hongchen1092/2-WayFSOCommunication/README.md

# 2-WayFSOCommunication
Design project with regards to a 2-way free space optical communications system, using optical laser transmitter &amp; photodiode sensor receiver
