hongchen1092/2-WayFSOCommunication/Code/Combined_Final/Rx_Device/readme.md

code for rx (device side) of the setup
no any managed components or build files
do a fresh clean build - .yml handles all required components
