hongchen1092/2-WayFSOCommunication/Simulations/Final Receiver.jpg

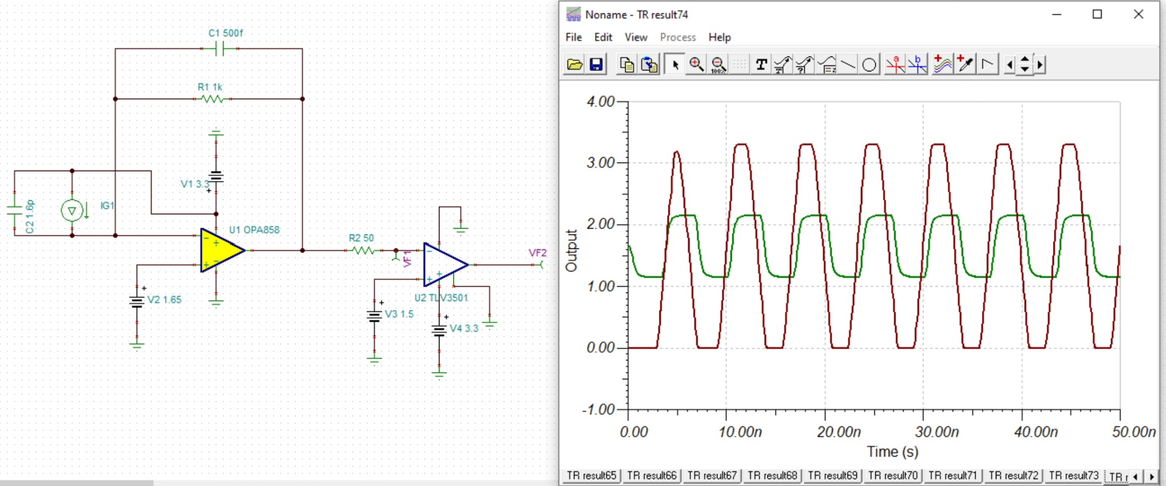
Simulations/Final Receiver.jpg
