hongchen1092/2-WayFSOCommunication/PCB Files/Test PCB version 3.0/BOM_END-PCB-Design-Project-2025_2025-10-28.csv

ID | Name | Designator | Footprint | Quantity | Manufacturer Part | Manufacturer | Supplier | Supplier Part | Price
1 | 1kΩ | R3 | R0402 | 1 | ERA2AEB102X | PANASONIC(松下) | LCSC | C445596
2 | 100nF | C10,C18,C4,C6,C8 | C0402 | 5 | CL05B104KO5NNNC | SAMSUNG(三星) | LCSC | C1525
3 | 4.7uF | C19,C20,C7,C9 | C0402 | 4 | CL05A475MP5NRNC | SAMSUNG(三星) | LCSC | C23733
4 | S8050T_C22435136 | Q2,Q3 | SOT-523-3_L1.6-W0.8-P1.00-LS1.6-BR | 2 | S8050T | TECH PUBLIC(台舟) | LCSC | C22435136
5 | 10kΩ | R2,R9 | R0402 | 2 | 0402WGF1002TCE | UNI-ROYAL(厚声) | LCSC | C25744
6 | CH343P | U8 | TQFN-16_L3.0-W3.0-P0.50-BL-EP1.7 | 1 | CH343P | WCH(南京沁恒) | LCSC | C2846043
7 | USB90-01-T1-W | USB,SERIAL | USB-A-TH_USB90-02-T1-3A-B1 | 2 | USB90-01-T1-W | Yuandi(元迪) | LCSC | C7419758
8 | 10uF | C1,C3 | C0603 | 2 | CL10A106MA8NRNC | SAMSUNG(三星) | LCSC | C96446
9 | 22uF | C2,C5 | C0805 | 2 | CL21A226MAQNNNE | SAMSUNG(三星) | LCSC | C45783
10 | 10nF | C11,C12,C13,C15,C16,C17 | C0402 | 6 | CL05B103KB5NNNC | SAMSUNG(三星) | LCSC | C15195
11 | 0.5pF | C14 | C0402 | 1 | GJM1555C1HR50WB01D | muRata(村田) | LCSC | C76912
12 | 100uF | C22 | C1210 | 1 | EMK325ABJ107MM-P | TAIYO YUDEN(太诱) | LCSC | C90143
13 | 0603White light_C2290 | LED2 | LED0603-R-RD_WHITE | 1 | KT-0603W | KENTO | LCSC | C2290
14 | S5973 | PD1 | TO-18-3 | 1
15 | 2N7002,215 | Q1 | SOT-23_L2.9-W1.3-P1.90-LS2.4-BR | 1 | 2N7002,215 | Nexperia(安世) | LCSC | C65189
16 | 200Ω | R1 | RES-ADJ-TH_3296X-8MM | 1 | 3296X-1-201-8mm | BOCHEN(博晨) | LCSC | C330440
17 | 1kΩ | R4,R5,R13 | R0402 | 3 | 0402WGF1001TCE | UNI-ROYAL(厚声) | LCSC | C11702
18 | 10Ω | R6 | R0402 | 1 | AR02BTC0100 | Viking(光颉) | LCSC | C319919
19 | 10kΩ | R11,R22 | R0402 | 2 | RT0402FRE0710KL | YAGEO(国巨) | LCSC | C723366
20 | 50Ω | U3 | R0402 | 1 | RT0402BRE0750RL | YAGEO(国巨) | LCSC | C853312
21 | 4.7Ω | R7 | R0805 | 1 | AS05W2J047JT5E | UNI-ROYAL(厚声) | LCSC | C2770032
22 | 75Ω | R8 | R0603 | 1 | ERJPA3F75R0V | PANASONIC(松下) | LCSC | C441915
23 | B3U-1000P | SW1,SW2 | KEY-SMD_B3U-1000PM | 2 | B3U-1000P | OMRON(欧姆龙) | LCSC | C231329
24 | TLV3501AIDBVRG4 | U1 | SOT-23-6_L2.9-W1.6-P0.95-LS2.8-BR | 1 | TLV3501AIDBVRG4 | TI(德州仪器) | LCSC | C3658928
25 | AMS1117-3.3 | U2 | SOT-223-3_L6.5-W3.4-P2.30-LS7.0-BR | 1 | AMS1117-3.3 | AMS | LCSC | C6186
26 | ESP32-S3-WROOM-1(N16) | U4 | WIRELM-SMD_ESP32-S3-WROOM-1 | 1 | ESP32-S3-WROOM-1-N16 | ESPRESSIF(乐鑫) | LCSC | C2913199
27 | RBS1MM40ATR | U5 | SOD-123FL_L2.6-W1.6-LS3.5-RD | 1 | RBS1MM40ATR | ROHM(罗姆) | LCSC | C5336770
28 | OPA858IDSGR | U6 | WSON-8_L2.0-W2.0-P0.50-TL-EP | 1 | OPA858IDSGR | TI(德州仪器) | LCSC | C970232
29 | UCC27512MDRSTEP | U7 | SON-6_L3.0-W3.0-P0.95-TL-EP | 1 | UCC27512MDRSTEP | TI(德州仪器) | LCSC | C2677110
30 | 5kΩ | VR1 | RES-ADJ-SMD_3224W | 1 | 3224W-1-502E | BOURNS | LCSC | C81349
31 | Laserdiode_TO18(5_6) | LD1 | LASER DIODE 5.6MM PCB | 1 |  |  |  | HLD980050N4T
32 | KT-0603R | LED1 | LED0603-RD | 1 | KT-0603R | KENTO | LCSC | C2286
