hongchen1092/2-WayFSOCommunication/Budget Summary/Project Budget.xlsx

Column5 | Column1 | Column2 | Column3 | Column32 | Column4
# | Item | Supplier | Invoice # | Avilability | Amount (AUD)
1 | ESP32 MCU + USB A Port | Altronics | 1 | yes | 46.7
2 | Laser, LDR, Sliding Pot and Mosfet | Jaycar | 2 | yes | 23.25
3 | Photodiodes SHP203 P | RS Components | 3 | yes | 10.1
4 | Test PCB (5 pack) | JLC PCB | 4 | yes | 29.55
5 | Components for PCB Assembly (in USD) | LCSC Parts | 5 | yes | 140.27
6 | Laser Lenses | AliExpress | 6 | yes | 16.71
7 | Final PCB with half SMT Assembly | JLC PCB | 7 | yes | 163.74
8 | Enclosure + Shipping | JLC3D | 8 | yes | 31.2
9 | Resistors (10K, 220ohm,1k) | Altronics | 9 | yes | 3.9
10 | Nut and bolts for enclouser (M3 25mm) | Bunnings | 10 | yes | 2.8
11 | Heat srink, Wires | Altronics | 11 | yes | 3.4
12 | Miscellaneous (Cleanig agent, solder and wires) |  | None | Wear items | 9.5
13 | Alignment Tripods | Kmart | 12 | yes | 13
 |  | Total |  |  | 494.12
