hongchen1092/2-WayFSOCommunication/Enclosure/TOP.stl

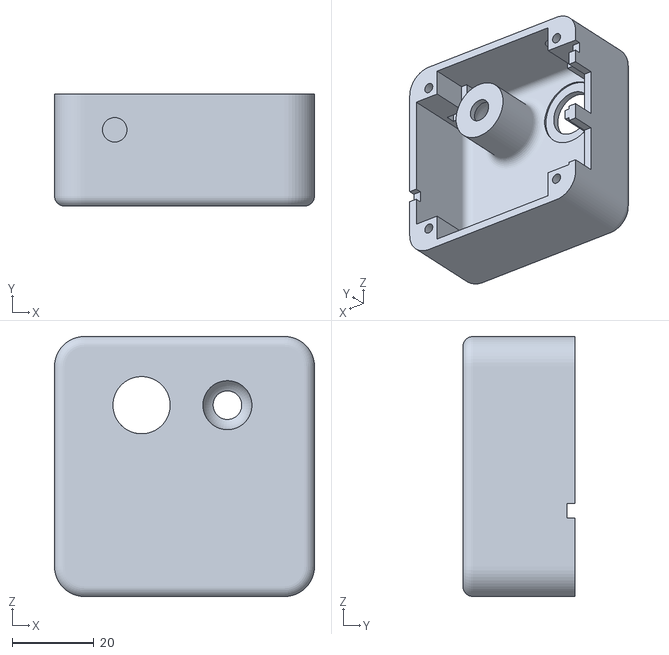
[picture p2: CAD file, 2025-10-28]
Enclosure/TOP.stl
63.6 x 27.5 x 63.6
