hongchen1092/2-WayFSOCommunication/Enclosure/Bottom.stl

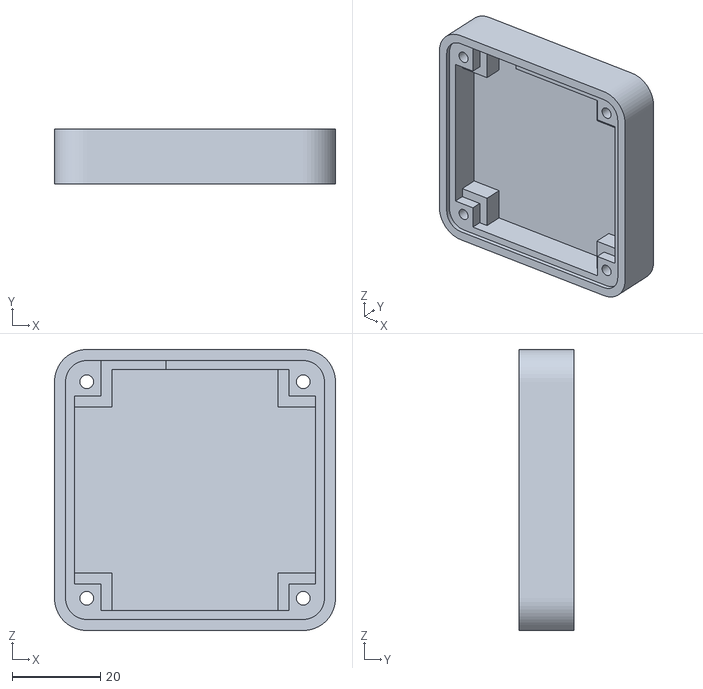
[picture p3: CAD file, 2025-10-28]
Enclosure/Bottom.stl
63.6 x 12.5 x 63.6
