hongchen1092/2-WayFSOCommunication/Lab-Test oscilloscope results/IN vs Comparator OUT.png

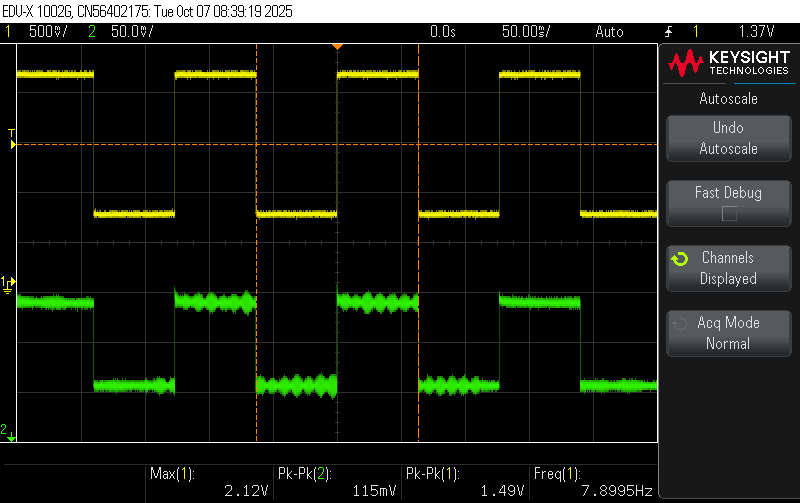
Lab-Test oscilloscope results/IN vs Comparator OUT.png
