hongchen1092/2-WayFSOCommunication/Lab-Test oscilloscope results/IN vs OPamp OUT.png

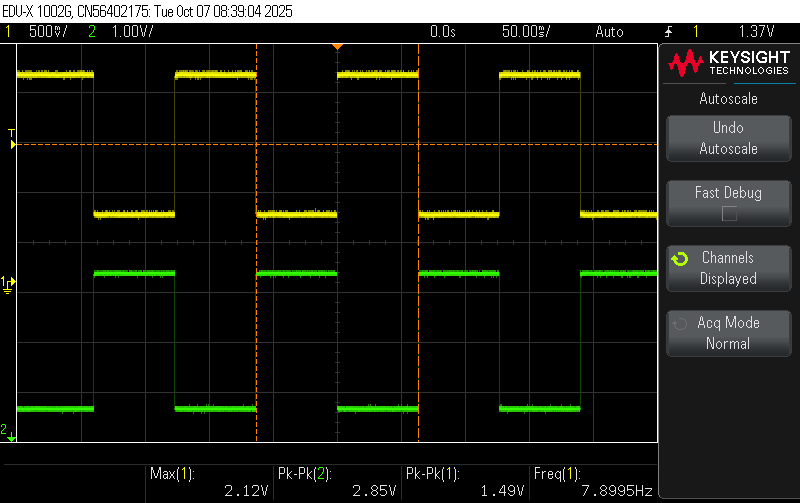
Lab-Test oscilloscope results/IN vs OPamp OUT.png
