hongchen1092/2-WayFSOCommunication/Lab-Test oscilloscope results/Link Propagation Delay.png

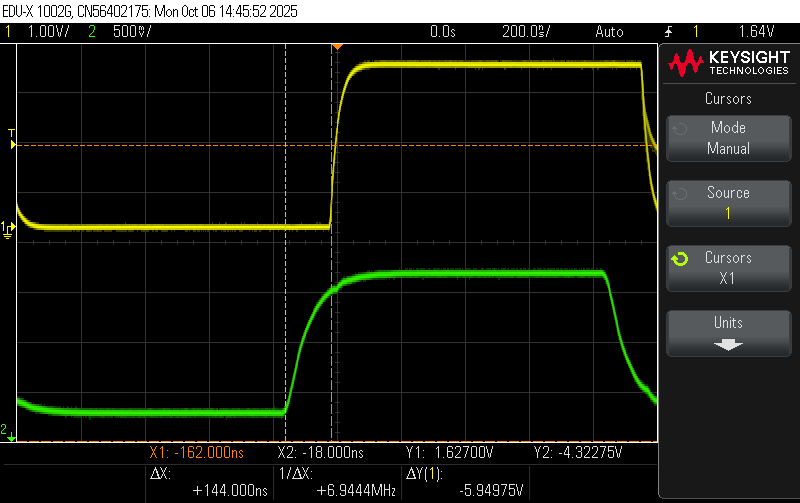
Lab-Test oscilloscope results/Link Propagation Delay.png
