hongchen1092/2-WayFSOCommunication/Lab-Test oscilloscope results/Receiver/Vout vs Rx Out.png

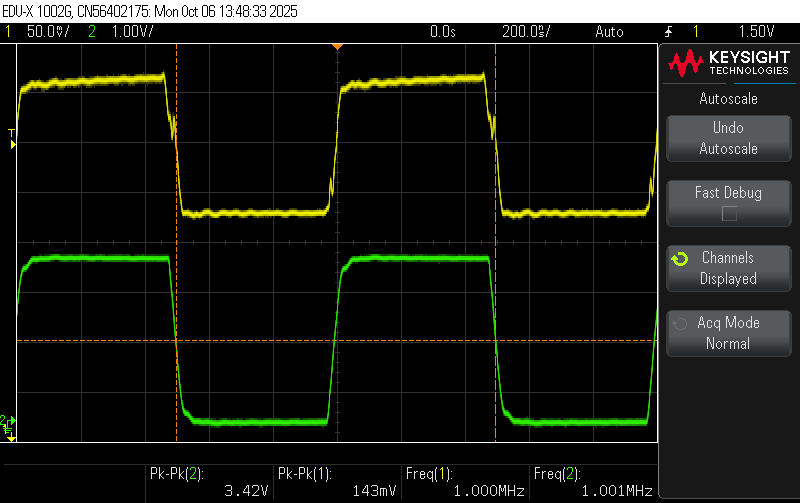
Lab-Test oscilloscope results/Receiver/Vout vs Rx Out.png
