hongchen1092/2-WayFSOCommunication/Lab-Test oscilloscope results/Receiver/Vref Tune.png

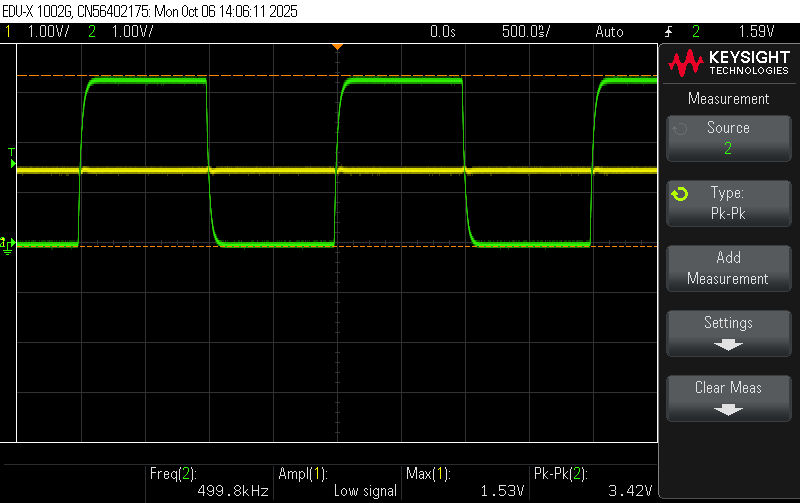
Lab-Test oscilloscope results/Receiver/Vref Tune.png
