hongchen1092/2-WayFSOCommunication/Lab-Test oscilloscope results/Transmitter/Tx In.png

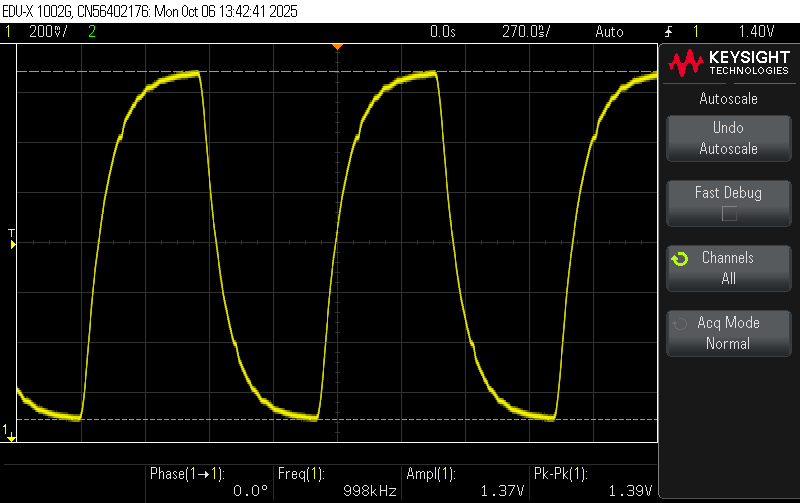
Lab-Test oscilloscope results/Transmitter/Tx In.png
