hongchen1092/2-WayFSOCommunication/Lab-Test oscilloscope results/Transmitter/Tx Out.png

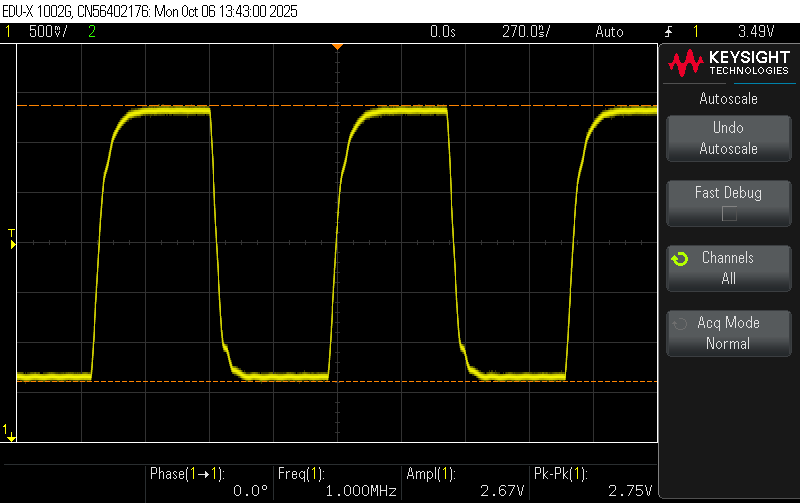
Lab-Test oscilloscope results/Transmitter/Tx Out.png
