hongchen1092/2-WayFSOCommunication/Schematics/Final Schematic_Design-Project-v3.0.pdf

## TX1VCC

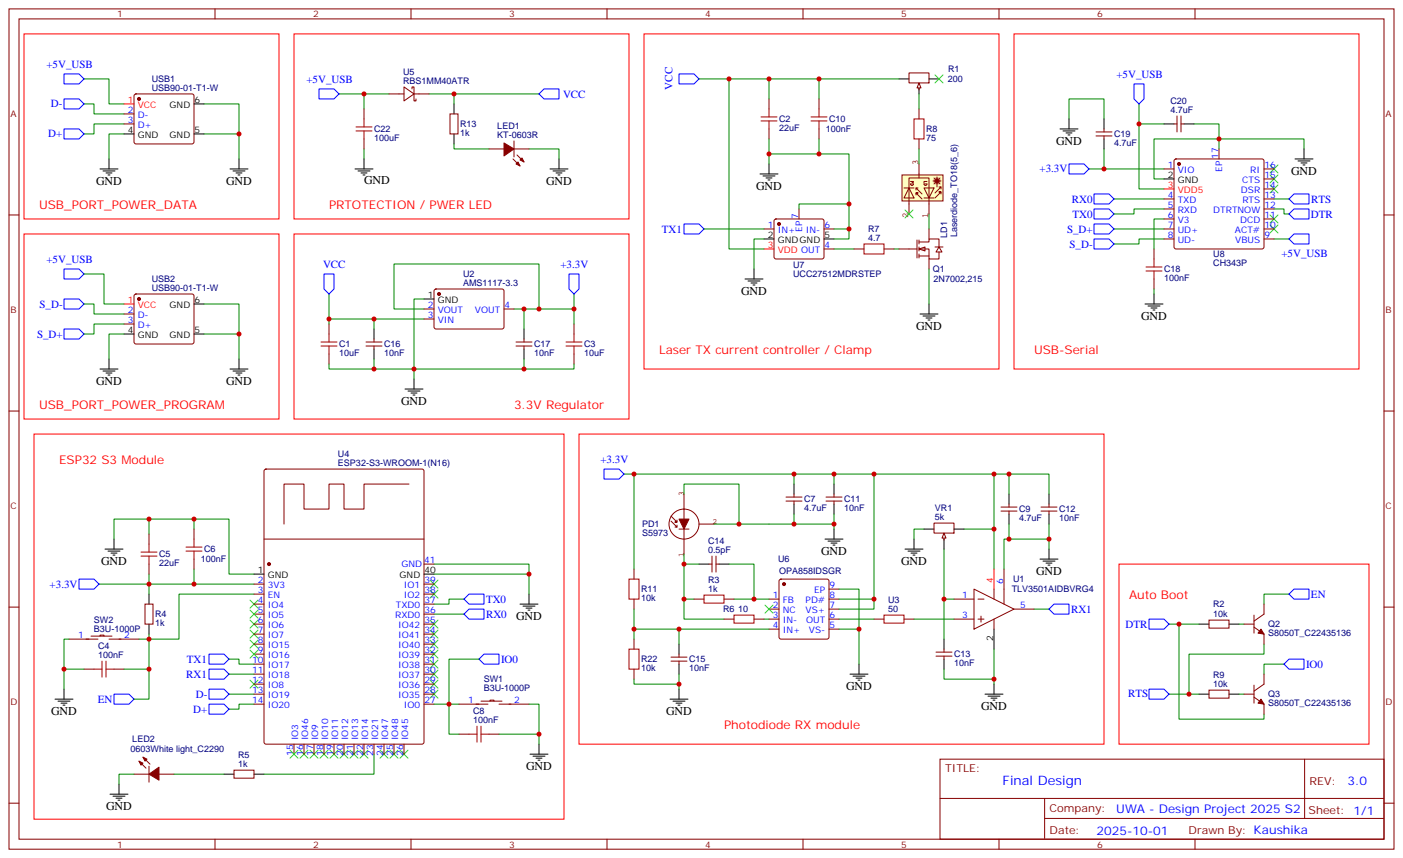
[picture p14: page 1]

Laser TX current controller / Clamp

Company: UWA - Design Project 2025 S2
