hongchen1092/2-WayFSOCommunication/Schematics/Archive/Schematic_Design-Project-v1.0.pdf

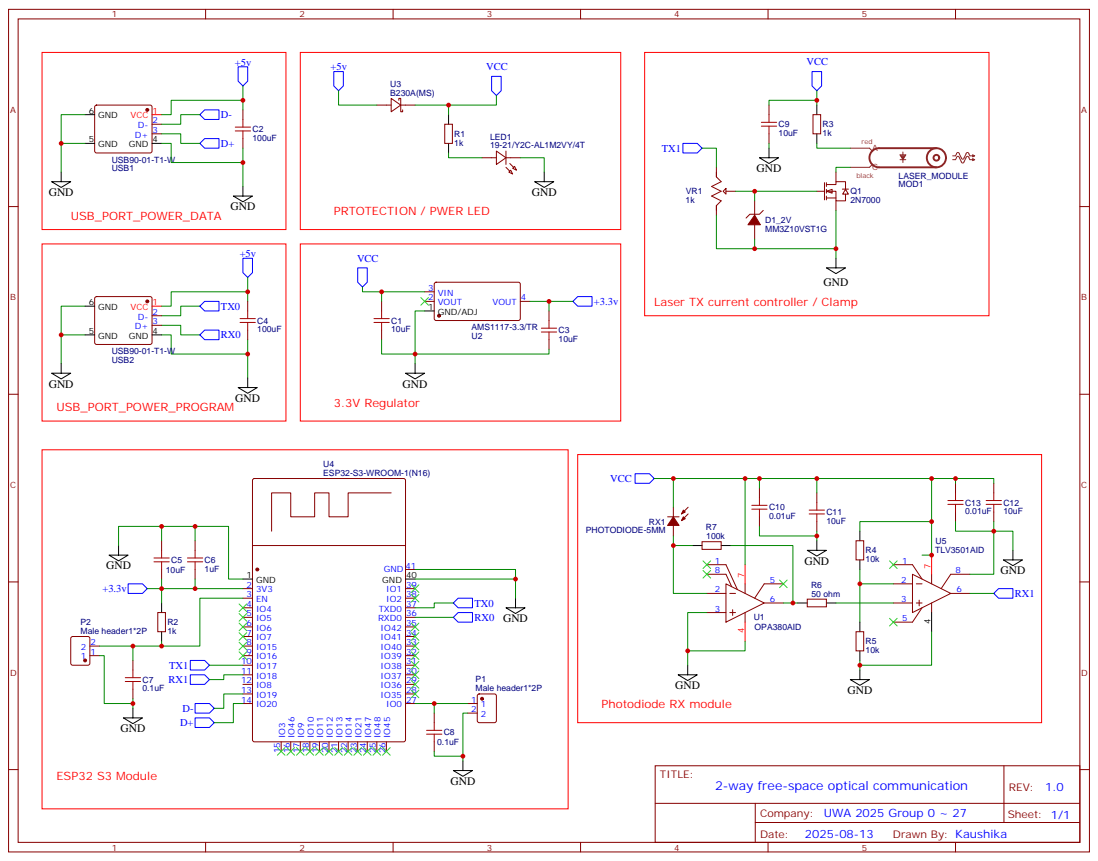
[picture p15: page 1]

Laser TX current controller / Clamp
