hongchen1092/2-WayFSOCommunication/Schematics/Archive/Schematic_Design-Project-v1.1.pdf

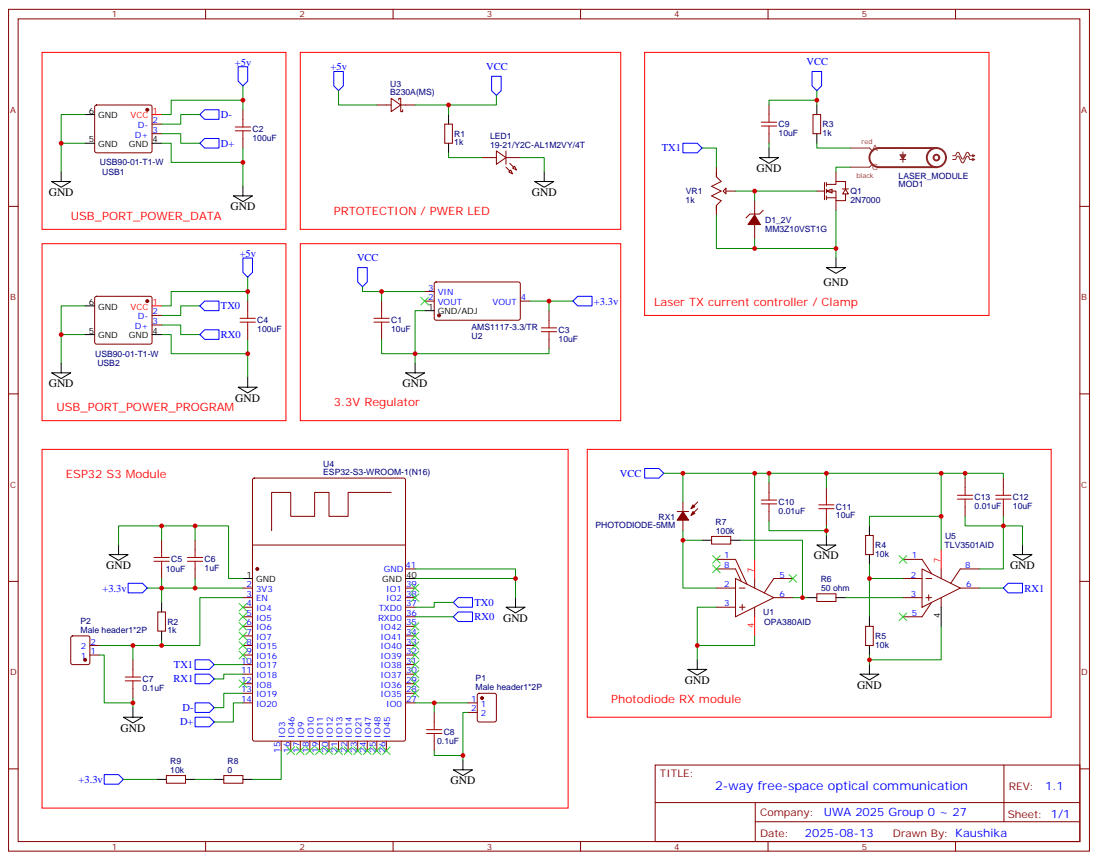
[picture p16: page 1]

Laser TX current controller / Clamp
