hongchen1092/2-WayFSOCommunication/Schematics/Archive/Schematic_Design-Project-v1.2.pdf

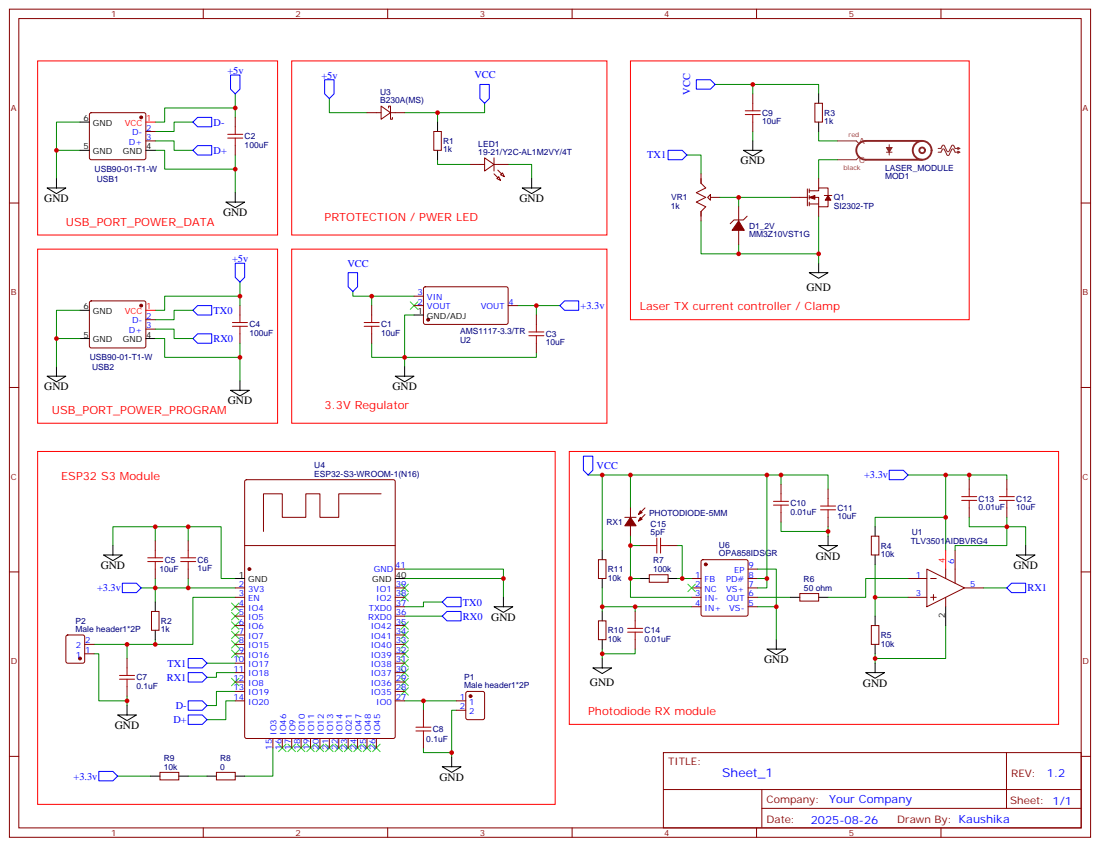
[picture p17: page 1]

Laser TX current controller / Clamp
