hongchen1092/2-WayFSOCommunication/Schematics/Archive/Schematic_Design-Project-v1.8.pdf

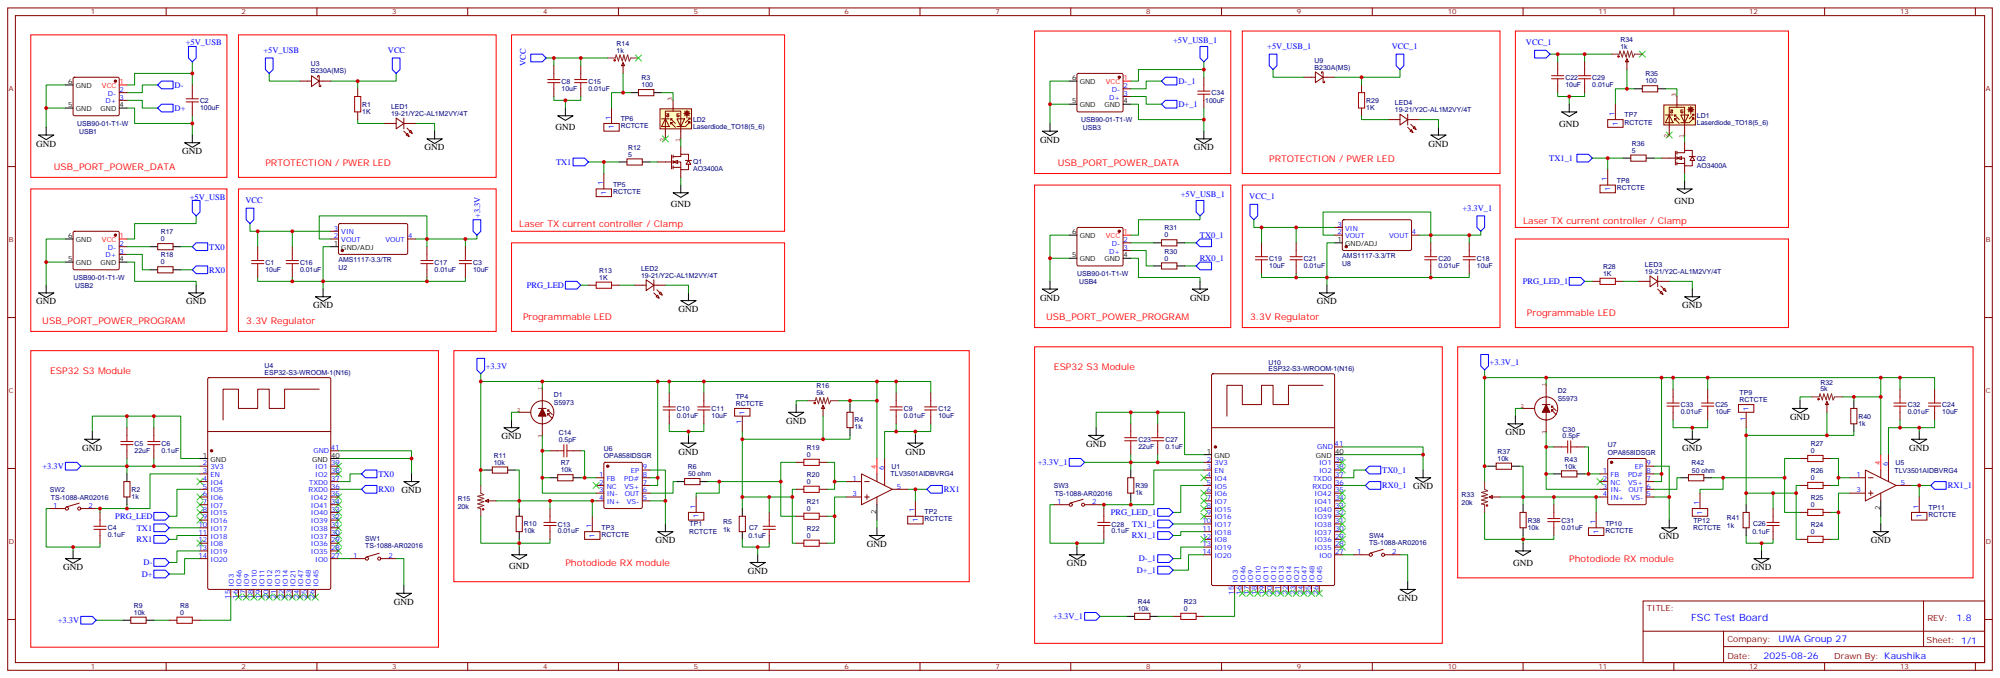
[picture p18: page 1]

Laser TX current controller / Clamp
