hongchen1092/2-WayFSOCommunication/Schematics/Archive/Schematic_Design-Project-v2.0.pdf

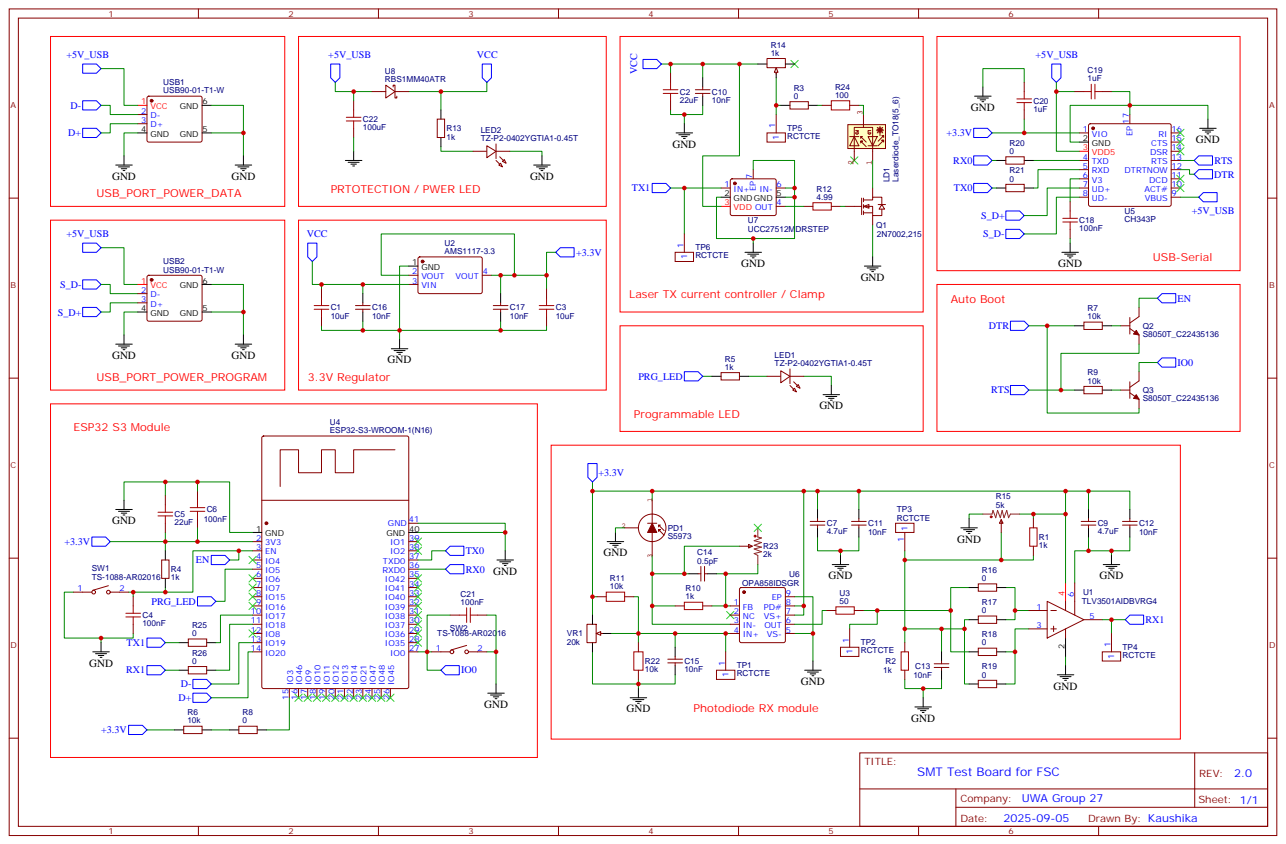
[picture p19: page 1]

Laser TX current controller / Clamp
