hongchen1092/2-WayFSOCommunication/Schematics/Archive/Schematic_Design-Project-v2.1.pdf

## TX0VCC

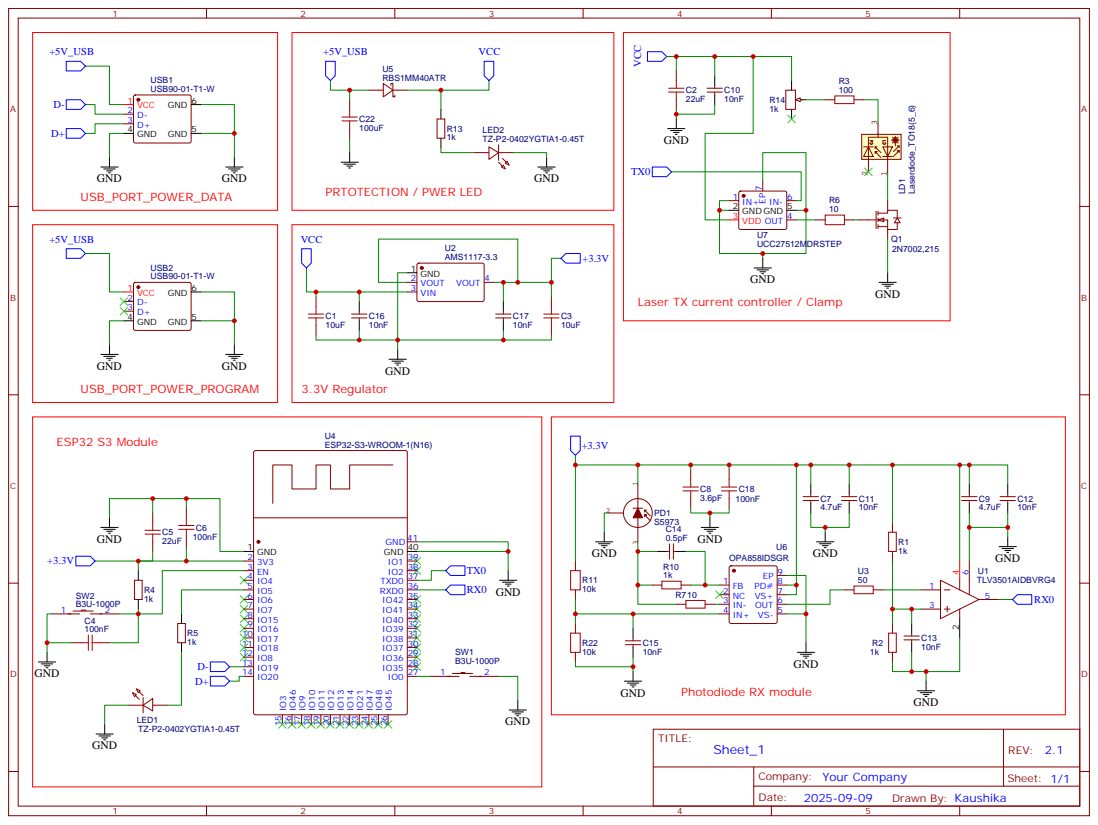
[picture p20: page 1]

Laser TX current controller / Clamp
