hongchen1092/2-WayFSOCommunication/Simulations/Regulator.asc

C1: cap; 10n
C2: cap; 10n
C3: cap; 10n
C4: cap; 10n
R1: res; 10
U2: LT1117-3.3
V1: voltage; 5; Rser=0
Named nets: 0
.tran 1n
