hongchen1092/2-WayFSOCommunication/Simulations/Transmitter v1.asc

D1: diode
M1: nmos; 2N7002
R1: res; 50
RL: res; 100
V_IN: voltage; PULSE(0 3.3 0 1p 1p 200n 400n)
V_Supply: voltage; 5V
Named nets: 0
.tran 1000n
