hongchen1092/2-WayFSOCommunication/(commit log)

2025-10-28 Add initial project files
    [BOM_END-PCB-Design-Project-2025_2025-10-28.csv, BOM_SMT-design-Project-Test-Board-2025_2025-10-28.csv, Bottom.stl, Final design 2025 project v9.f3d, PickAndPlace_LAST-PCB_2025-10-28.csv, PickAndPlace_NEW_PCB_2025-10-28.csv, Project Budget.xlsx, Single board v1.f3d]
2025-10-28 Remove unused folder
    [BOM_Design-Project-Group-27-2025.xlsx, Bottom.stl, Final design 2025 project v9.f3d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]
